UzixLS/atfblast/README.md

## ATFBlast/U

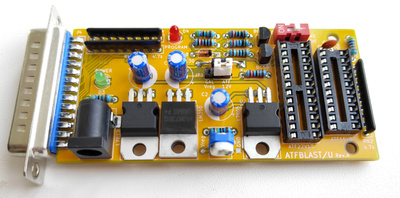
[picture p1: images/photo.small.jpg]


ATF16V8, GAL16V8, ATF22V10 and GAL22V10 chips programmer.

This is custom PCB variant of ATFBlast project.

See http://www.bhabbott.net.nz/atfblast.html for details.
