UzixLS/atfblast/doc/references/atf_blast_v21_sch.png

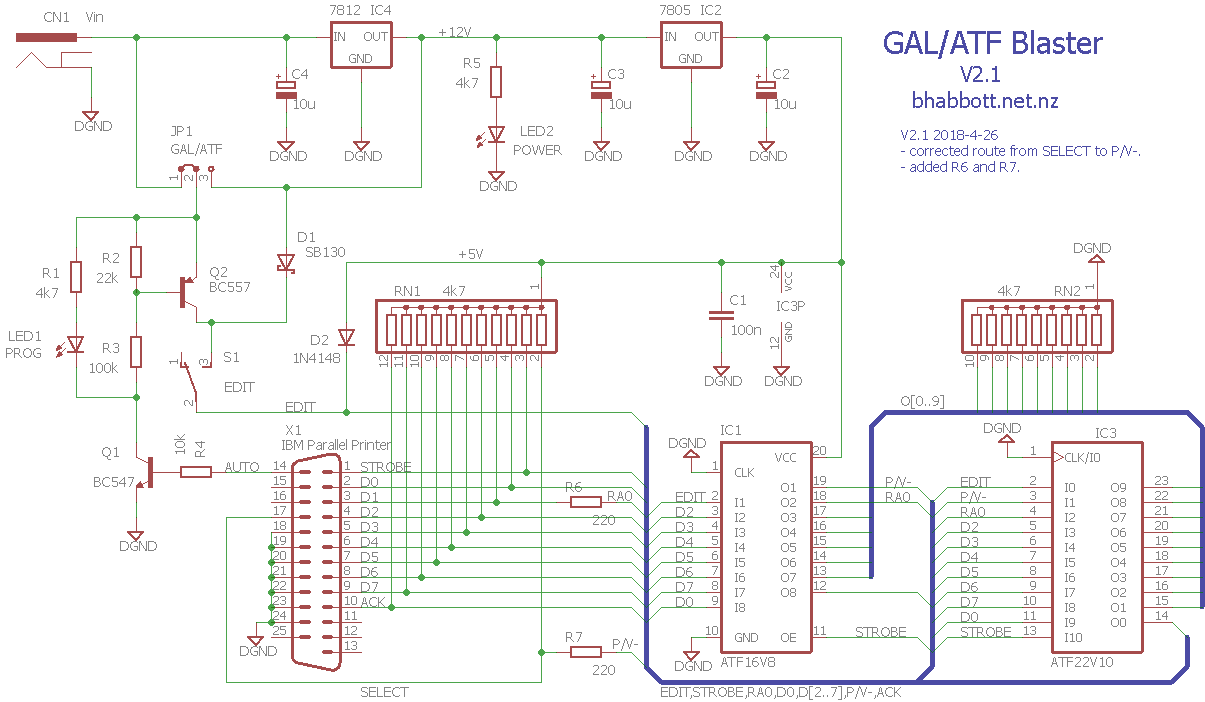
doc/references/atf_blast_v21_sch.png
