UzixLS/atfblast/doc/references/mini_atf v11.png

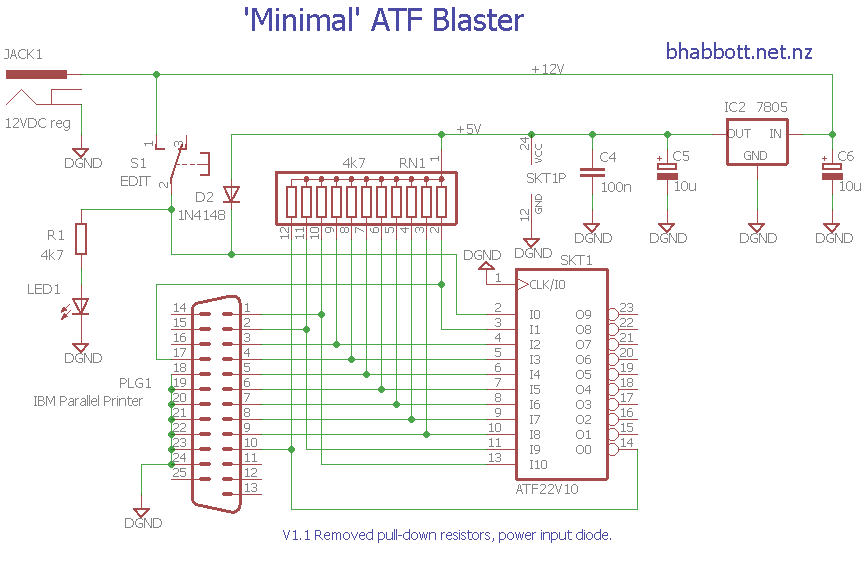
doc/references/mini_atf v11.png
