UzixLS/atfblast/out/pcb3d.png

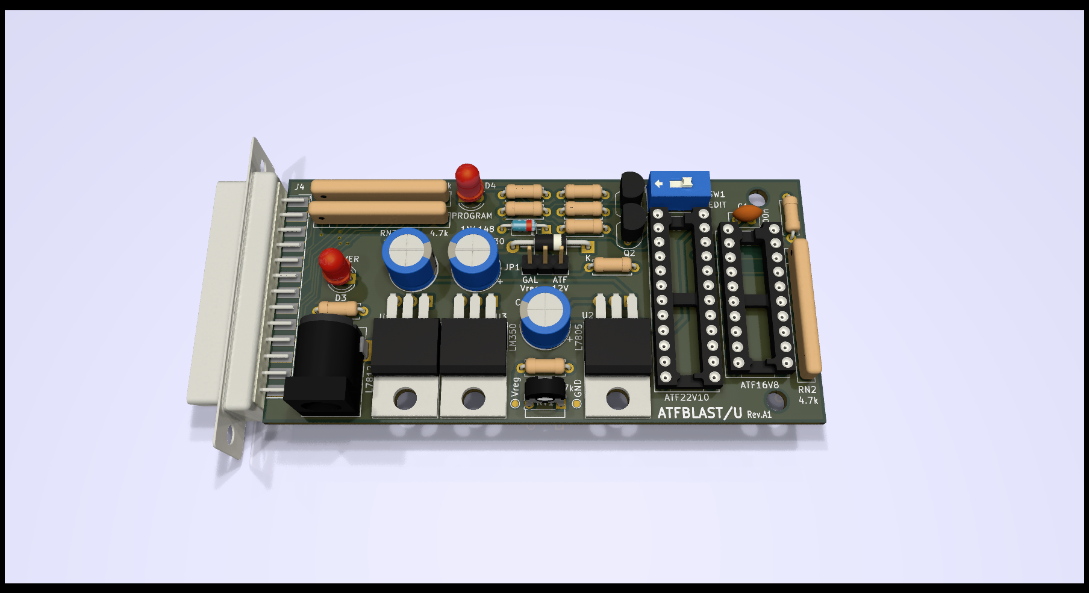
out/pcb3d.png
