UzixLS/atfblast/out/schematic.pdf

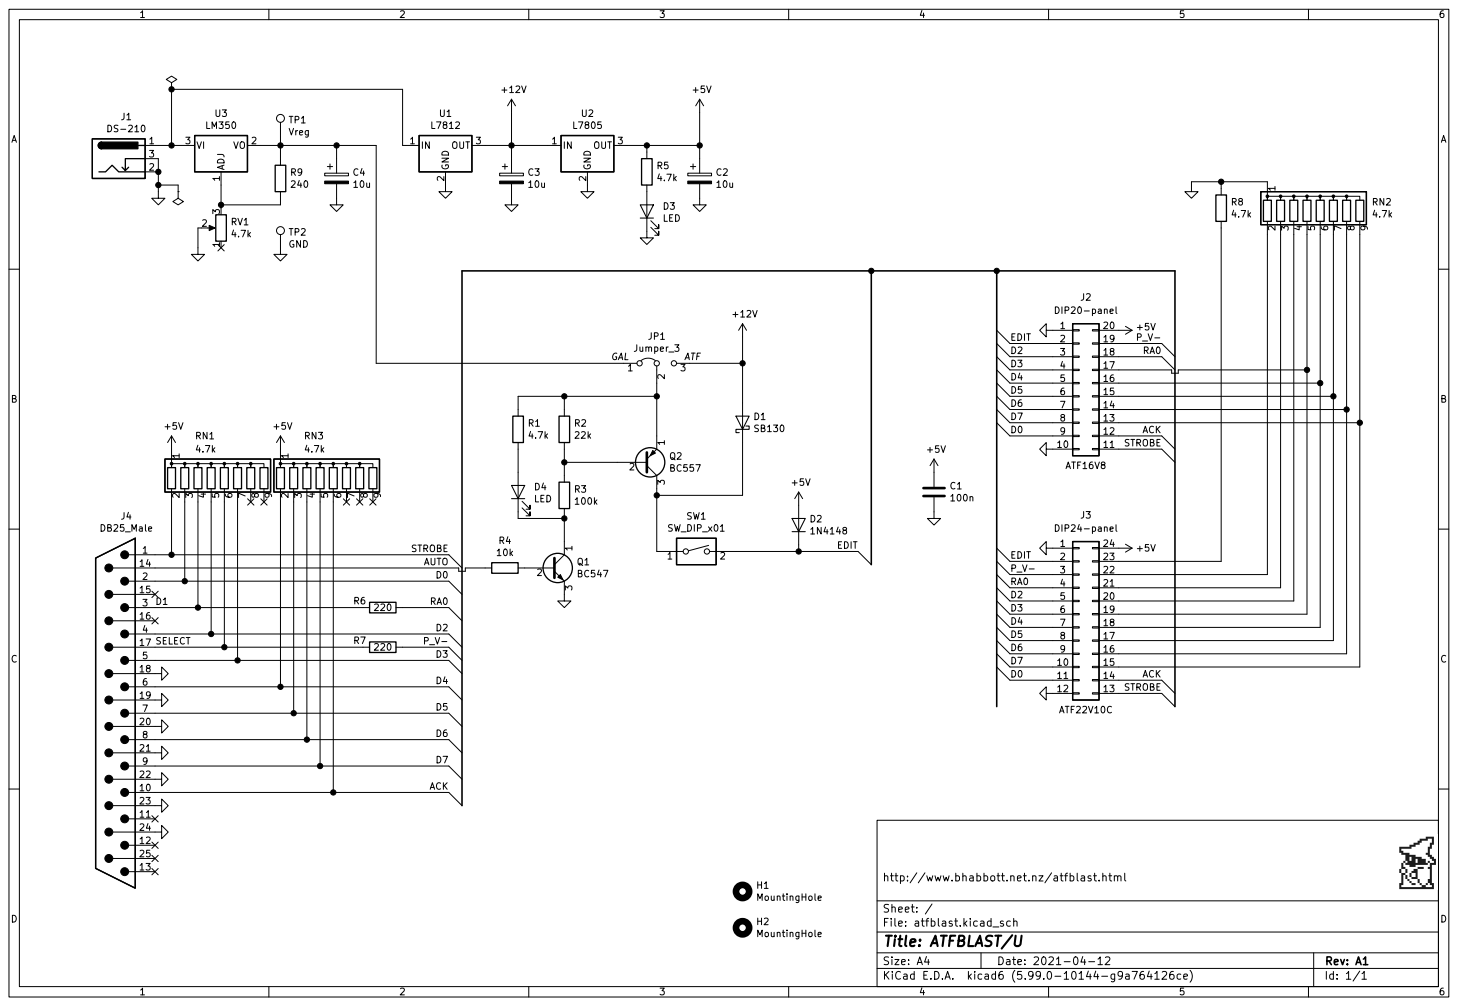
[picture p5: page 1]

File: atfblast.kicad_sch Sheet: / http://www.bhabbott.net.nz/atfblast.html
