UzixLS/atfblast/pcb/atfblast.kicad_pcb

## KiCad design pcb/atfblast.kicad_pcb (2021-04-12)

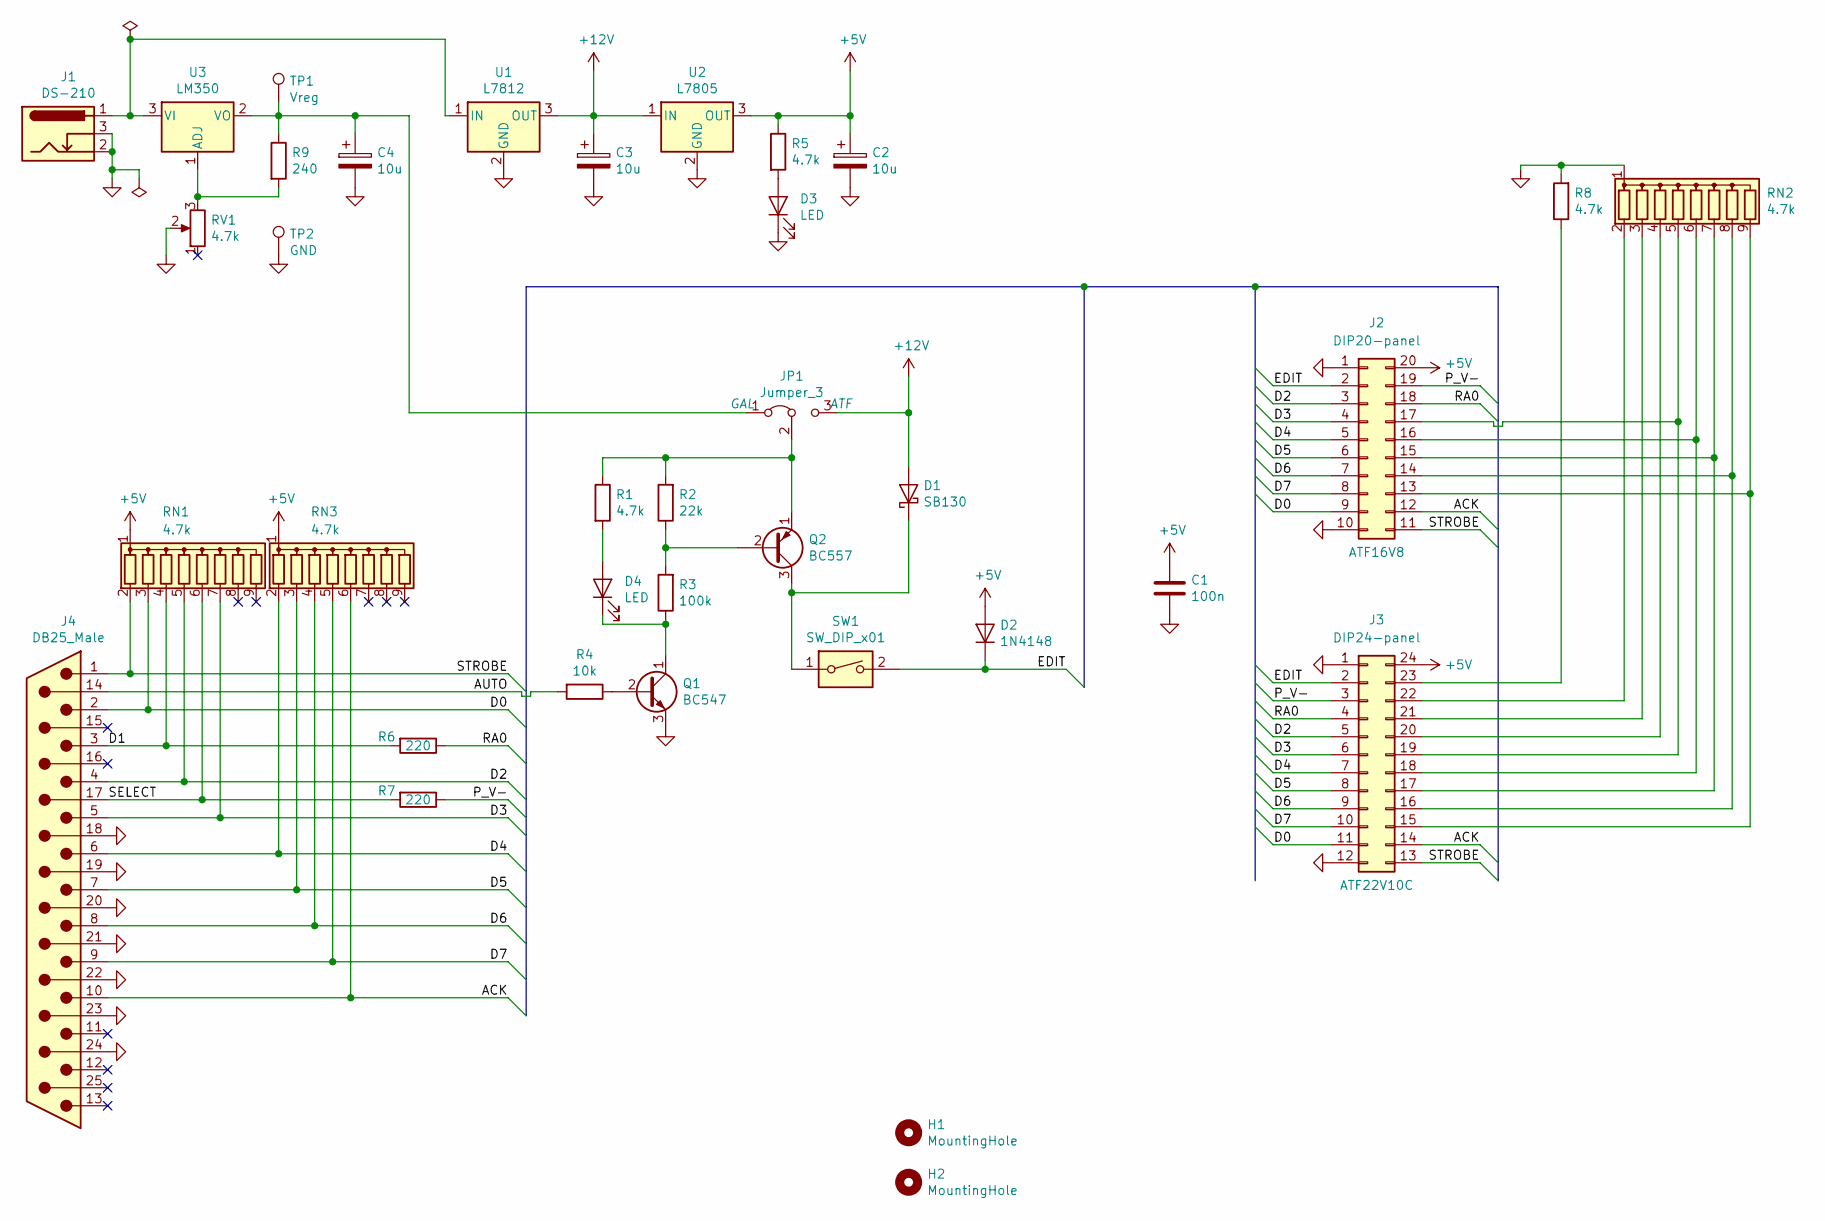
[picture p8: schematic atfblast.kicad_sch, ATFBLAST/U]

Parts:
C1: 100n; C_Disc_D5.0mm_W2.5mm_P2.50mm
C2, C3, C4: 10u; CP_Radial_D8.0mm_P3.50mm
D1: SB130; D_DO-41_SOD81_P12.70mm_Horizontal
D2: 1N4148; D_DO-35_SOD27_P7.62mm_Horizontal
D3, D4: LED; LED_D4.0mm
H1, H2: MountingHole; MountingHole_3.2mm_M3
J1: DS-210; BarrelJack_Horizontal
J2: DIP20-panel; DIP-20_W7.62mm_Socket
J3: DIP24-panel; DIP-24_W7.62mm_Socket
J4: DB25_Male; DSUB-25_Male_EdgeMount_P2.77mm
JP1: Jumper_3; PinHeader_1x03_P2.54mm_Vertical
Q1: BC547; TO-92
Q2: BC557; TO-92
R1, R5, R8: 4.7k; R_Axial_DIN0207_L6.3mm_D2.5mm_P7.62mm_Horizontal
R2: 22k; R_Axial_DIN0207_L6.3mm_D2.5mm_P7.62mm_Horizontal
R3: 100k; R_Axial_DIN0207_L6.3mm_D2.5mm_P7.62mm_Horizontal
R4: 10k; R_Axial_DIN0207_L6.3mm_D2.5mm_P7.62mm_Horizontal
R6, R7: 220; R_Axial_DIN0207_L6.3mm_D2.5mm_P7.62mm_Horizontal
R9: 240; R_Axial_DIN0207_L6.3mm_D2.5mm_P7.62mm_Horizontal
RN1, RN2, RN3: 4.7k; R_Array_SIP9
RV1: 4.7k; Potentiometer_Runtron_RM-063_Horizontal
SW1: SW_DIP_x01; SW_DIP_SPSTx01_Slide_9.78x4.72mm_W7.62mm_P2.54mm
TP1: Vreg; TestPoint_Pad_D1.0mm
TP2: GND; TestPoint_Pad_D1.0mm
U1: L7812; TO-220-3_Horizontal_TabDown
U2: L7805; TO-220-3_Horizontal_TabDown
U3: LM350; TO-220-3_Horizontal_TabDown

Connections:
+5V: C1.1, C2.1, D2.2 (A), J2.20, J3.24, R5.1, RN1.1 (common), RN3.1 (common), U2.3 (OUT)
+12V: C3.1, D1.2 (A), JP1.3 (B), U1.3 (OUT), U2.1 (IN)
/ACK: J2.12, J3.14, J4.10, RN3.6 (R5)
/AUTO: J4.14, R4.2
/D0: J2.9, J3.11, J4.2, RN1.3 (R2)
/D1: J4.3, R6.2, RN1.4 (R3)
/D2: J2.3, J3.5, J4.4, RN1.5 (R4)
/D3: J2.4, J3.6, J4.5, RN1.7 (R6)
/D4: J2.5, J3.7, J4.6, RN3.2 (R1)
/D5: J2.6, J3.8, J4.7, RN3.3 (R2)
/D6: J2.7, J3.9, J4.8, RN3.4 (R3)
/D7: J2.8, J3.10, J4.9, RN3.5 (R4)
/EDIT: D2.1 (K), J2.2, J3.2, SW1.2
/P_V-: J2.19, J3.3, R7.1
/RA0: J2.18, J3.4, R6.1
/SELECT: J4.17, R7.2, RN1.6 (R5)
/STROBE: J2.11, J3.13, J4.1, RN1.2 (R1)
GND: C1.2, C2.2, C3.2, C4.2, D3.1 (K), J1.2, J1.3, J2.1, J2.10, J3.1, J3.12, J4.18, J4.19, J4.20, J4.21, J4.22, J4.23, J4.24, Q1.3 (E), R8.2, RN2.1 (common), RV1.2, TP2.1, U1.2 (GND), U2.2 (GND)
unnamed: C4.1, JP1.1 (A), R9.1, TP1.1, U3.2 (VO)
unnamed: D1.1 (K), Q2.3 (C), SW1.1
unnamed: D3.2 (A), R5.2
unnamed: D4.1 (K), Q1.1 (C), R3.1
unnamed: D4.2 (A), R1.2
unnamed: J1.1, U1.1 (IN), U3.3 (VI)
unnamed: J2.13, J3.15, RN2.9 (R8)
unnamed: J2.14, J3.16, RN2.8 (R7)
unnamed: J2.15, J3.17, RN2.7 (R6)
unnamed: J2.16, J3.18, RN2.6 (R5)
unnamed: J2.17, J3.19, RN2.5 (R4)
unnamed: J3.20, RN2.4 (R3)
unnamed: J3.21, RN2.3 (R2)
unnamed: J3.22, RN2.2 (R1)
unnamed: J3.23, R8.1
unnamed: JP1.2 (C), Q2.1 (E), R1.1, R2.2
unnamed: Q1.2 (B), R4.1
unnamed: Q2.2 (B), R2.1, R3.2
unnamed: R9.2, RV1.3, U3.1 (ADJ)

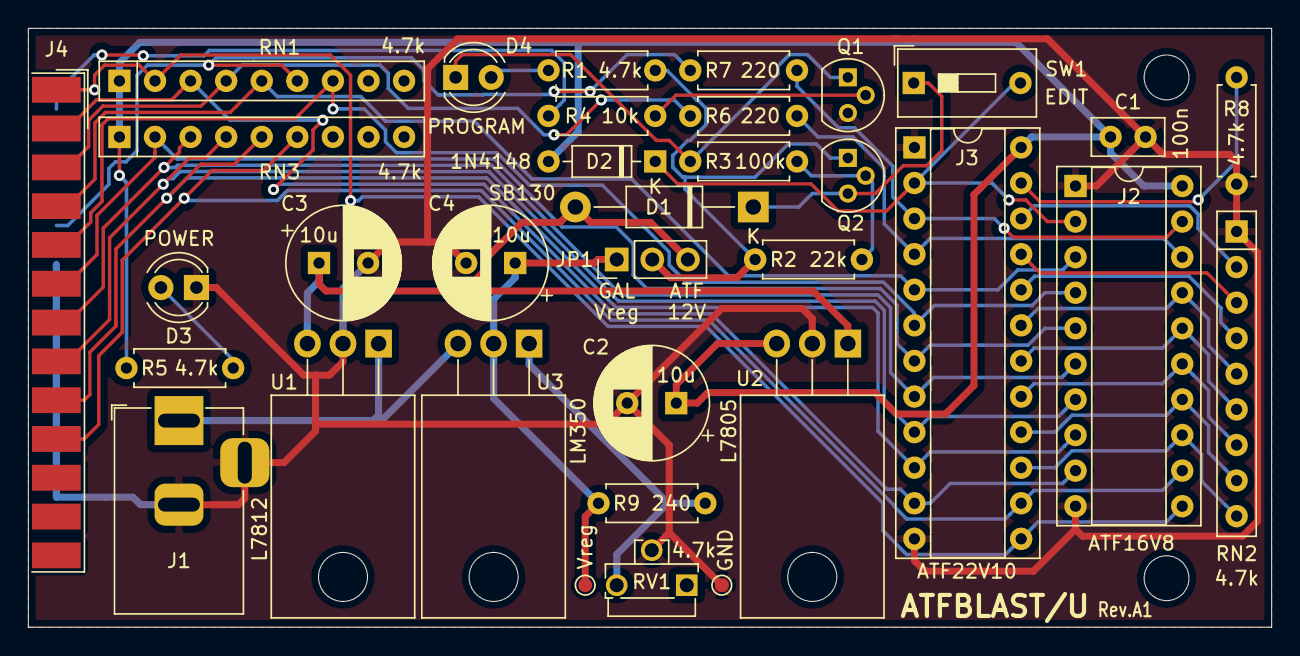
[picture p9: board atfblast.kicad_pcb from above]

Board: 2 copper layers, 88.8 x 42.8 mm, 36 parts (0 on the bottom side), 37 nets.
