UzixLS/atfblast/(commit log)

2021-04-09 add pcb rev.A
    [atfblast.kicad_pcb, atfblast.sch]
2021-04-12 add pcb rev.A1
    [atfblast.kicad_pcb, atfblast.kicad_sch, atfblast.sch]
2021-04-12 add prodution files for pcb rev.A1
